lautaroleon/Electropolleitor/asustado.png

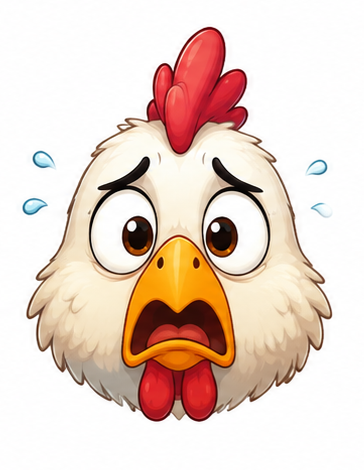
asustado.png
