lautaroleon/Electropolleitor/electrocuted.png

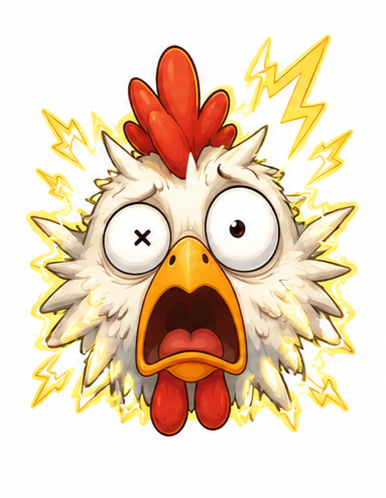
electrocuted.png
