lautaroleon/Electropolleitor/freaking.png

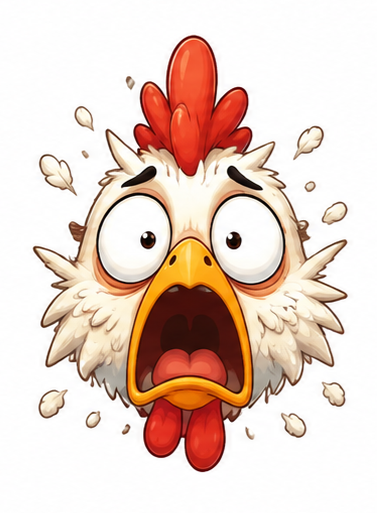
freaking.png
