lautaroleon/Electropolleitor/happy.png

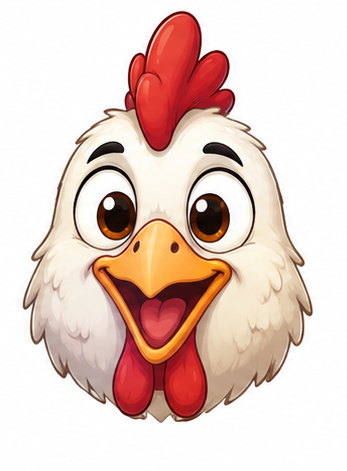
happy.png
