lautaroleon/Electropolleitor/(commit log)

2026-09-09 Initial commit: Qt Android app, ESP32 firmware, design documentation
    In-ovo electroporator for chicken eggs. Reimplements a working legacy
    device, keeping its LM317 + relay analogue front end and replacing the
    manual front-panel controls with an Android app over BLE.
    App (Qt 6.11, qmake, Widgets, arm64-v8a):
    - BLE central over the Nordic UART Service; the ESP32-S3 has no
    Bluetooth Classic, so NUS is the serial substitute
    - Device picker, parameter entry, arming state machine
    - Readouts display what the device acknowledged, never what was typed
    Firmware (Arduino Nano ESP32, arduino-esp32 core 2.x):
    - ble_link_test: NUS echo + heartbeat, for proving the link
    - ble_params: pa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
2026-09-09 firmware: close the voltage loop around the ADJ current sink
    ble_params.ino stored and echoed PV but never drove the hardware. Adds a
    12-bit PWM DAC on D3 and an integral trim loop that reads the sense divider
    back and converges to within 1 % of the setpoint.
    The slope is negative: more duty steals more current from the LM317 ADJ
    node, which lowers the output. Every sign in the loop follows from that.
    - Open-loop seed from the design equation lands within a few hundred mV,
    so the loop trims tolerances rather than searching the range
    - 60 ms service period, above 5 tau of the 10 ms ADJ filter
    - Deadband at the 1 % tolerance so ADC noise is not chased
    - Boot parks at full sink (1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
    [ble_params.ino]
2026-09-09 firmware: rebuild the voltage loop on the measured V0/K line
    Replaces the derived-from-nominals regulator with the bench-parameterised
    one. Three substantive changes, all of which matter on real hardware:
    Feed-forward from a MEASURED line. V_OUT(D) = CAL_V0 - CAL_K * D, with V0
    and K taken from two duty points against a DMM. Nominal component values
    give V0 = 44.65 / K = 82.5; the bench figures are 49.1 / 61.3, off by 10 %
    and 26 %. Computing the jump from nominals lands it ~4 V out and makes the
    integrator walk back a gap that should never have existed.
    Integrator hold after the jump. The RC filter lags ~60 ms; integrating
    through that lag is pure windup. Simulated against a 60 ms lag, a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
    [ble_params.ino]
